mikhailkrigman/ElectricNose/images/reale_schaltung.jpg

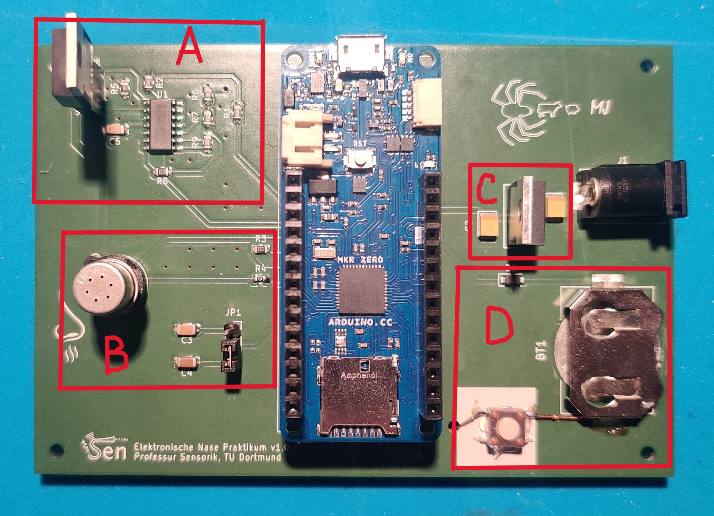
images/reale_schaltung.jpg
