mikhailkrigman/ElectricNose/Electric Schemes/Time-To-Digital_Schaltung.png

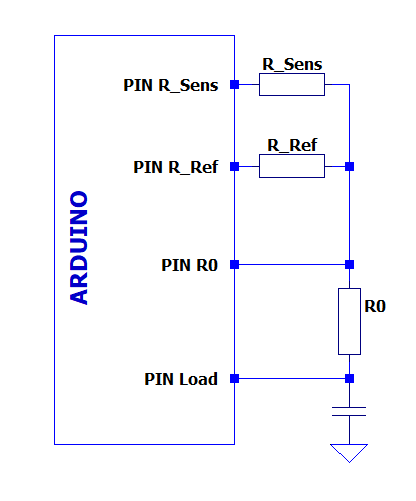
Electric Schemes/Time-To-Digital_Schaltung.png
