mikhailkrigman/ElectricNose/plots/PID_Charakteristik.png

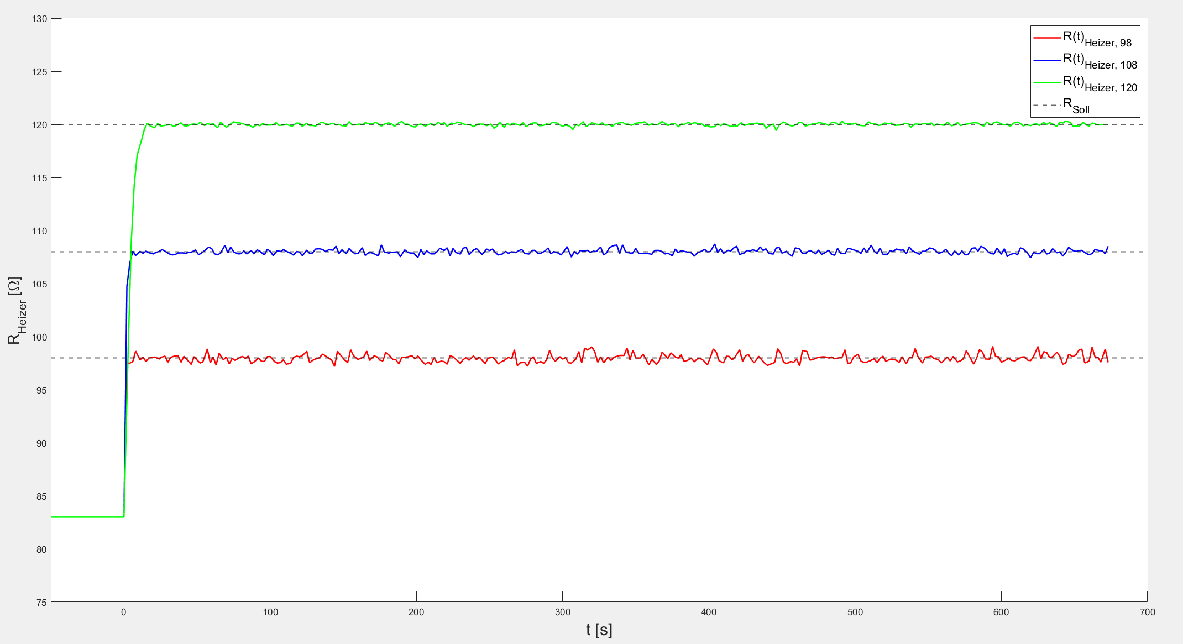
plots/PID_Charakteristik.png
