mikhailkrigman/ElectricNose/(commit log)

2024-03-12 Eelctric schemes
    electricity source with voltage controls, scheme for measuring of heater voltage, complete scheme
2024-03-13 Setup formatted data string
    Add string in loop to store sensor data
2024-03-14 Correct saving data
    Now will be saved in time_log
    [elektronische_nase.ino]
2024-03-14 add timers
    Rewrite loop to measure resistance for 15 min and wait for 54 min until next heater resistance will be set
